MajicDesigns/FX888-Controller/media/photo/SS_Assembly1.JPG

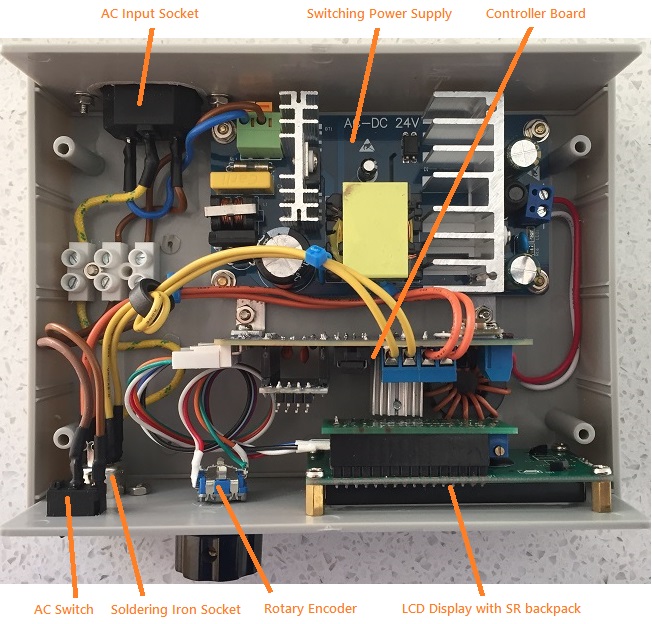
media/photo/SS_Assembly1.JPG
