MajicDesigns/FX888-Controller/media/photo/SS_BOM.jpg

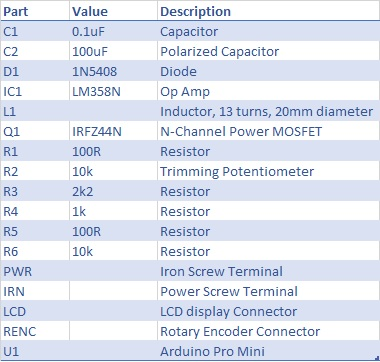
media/photo/SS_BOM.jpg
