MajicDesigns/FX888-Controller/README.md

Code to implement a Soldering station - Hakko Fx-888 soldering iron, LCD display and Rotary encoder user input.

Controller uses the PID algoritm and error shutdown is implemented.

This code accompanies the blog article at the [Arduino++ blog](https://arduinoplusplus.wordpress.com/2016/08/15/diy-soldering-station-with-hakko-fx-888-iron/)
