MajicDesigns/FX888-Controller/media/photo/SS_Block_Diagram.jpg

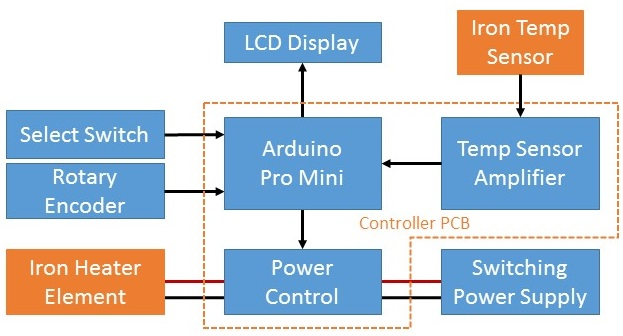
media/photo/SS_Block_Diagram.jpg
