MajicDesigns/FX888-Controller/media/photo/SS_Board1.JPG

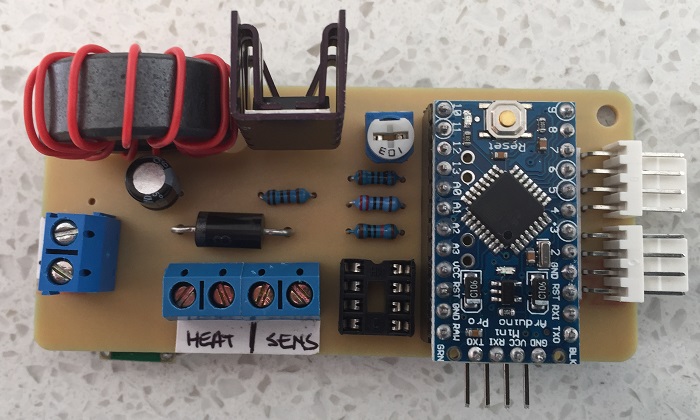
media/photo/SS_Board1.JPG
