MajicDesigns/FX888-Controller/media/photo/SS_Board2.JPG

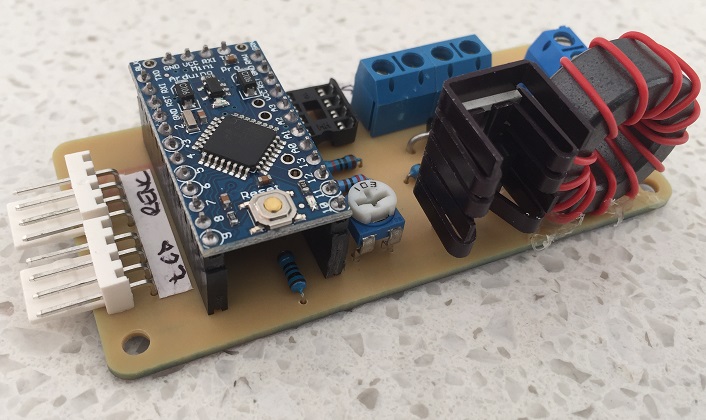
media/photo/SS_Board2.JPG
