MajicDesigns/FX888-Controller/media/photo/SS_Buck_Converter.JPG

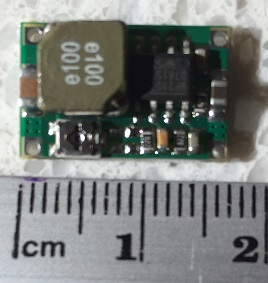
media/photo/SS_Buck_Converter.JPG
