MajicDesigns/FX888-Controller/media/photo/SS_Display_Design.jpg

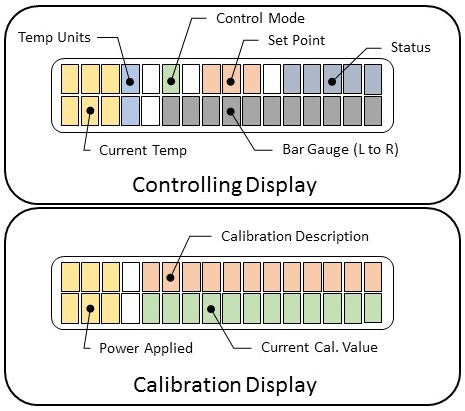
media/photo/SS_Display_Design.jpg
