MajicDesigns/FX888-Controller/media/photo/SS_Final.JPG

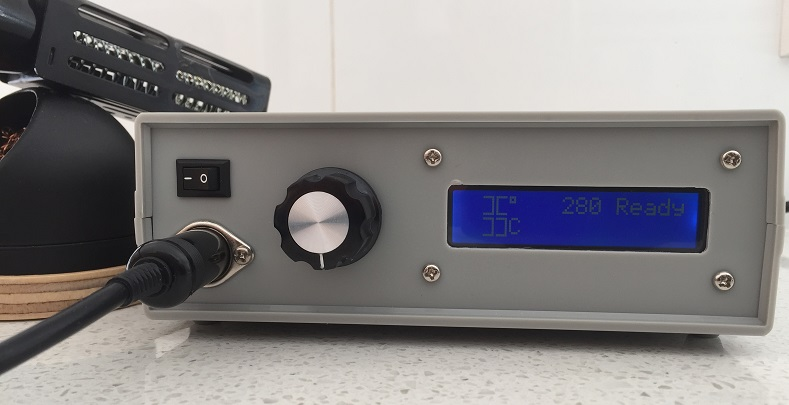
media/photo/SS_Final.JPG
