MajicDesigns/FX888-Controller/media/photo/SS_Front_Panel.JPG

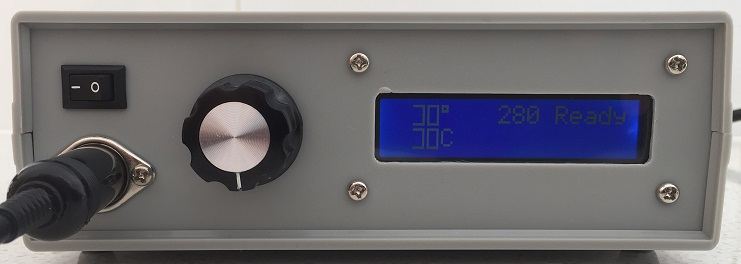
media/photo/SS_Front_Panel.JPG
