MajicDesigns/FX888-Controller/media/photo/SS_Hakko_FX888D_Pinouts.jpg

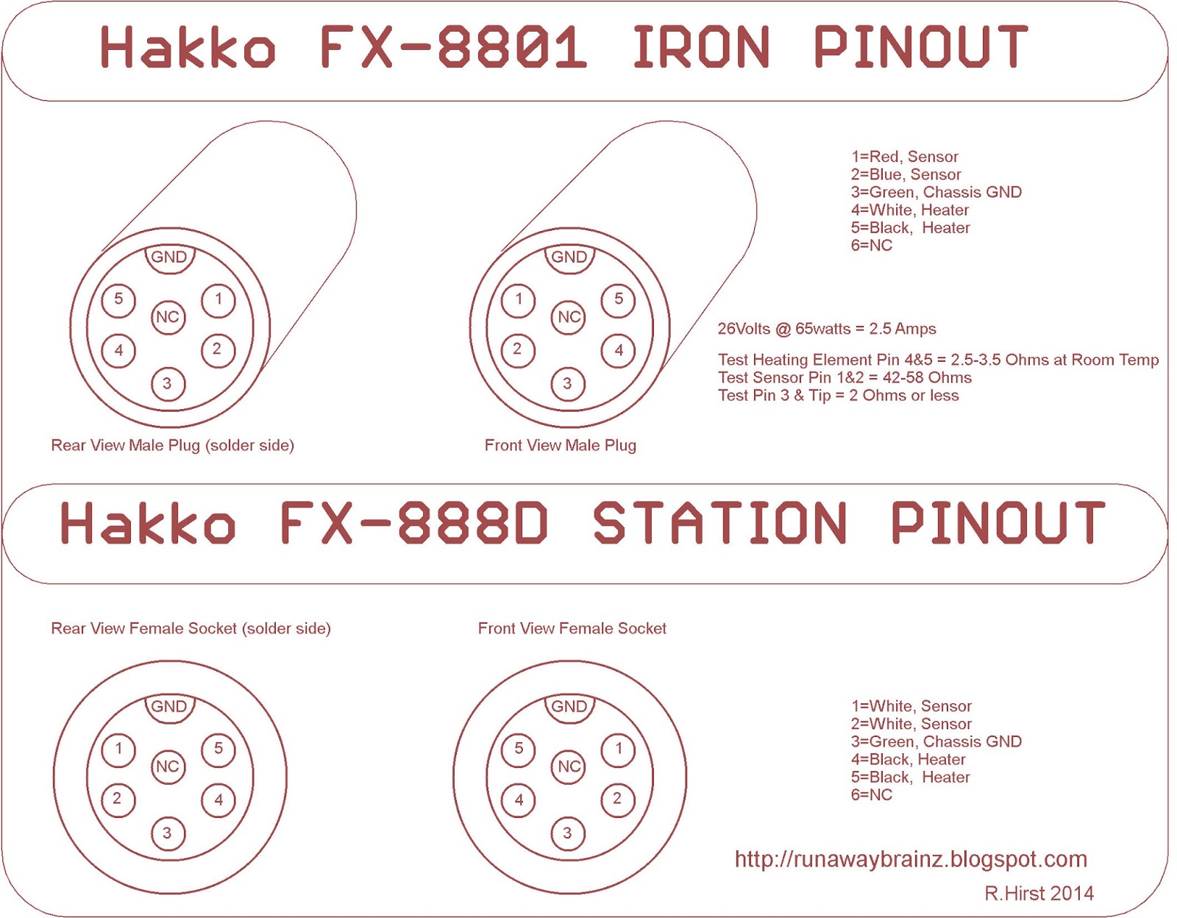
media/photo/SS_Hakko_FX888D_Pinouts.jpg
