MajicDesigns/FX888-Controller/media/photo/SS_Menu_Structure.jpg

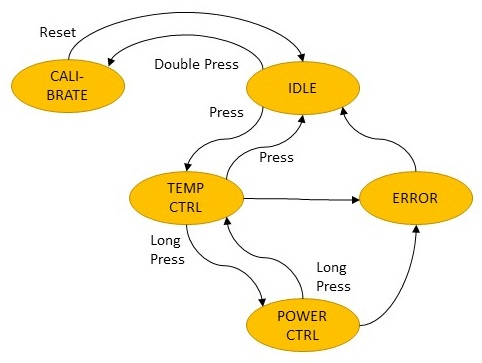
media/photo/SS_Menu_Structure.jpg
