MajicDesigns/FX888-Controller/media/photo/SS_PCB.JPG

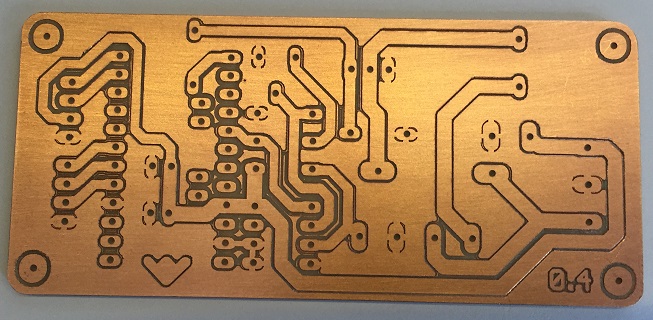
media/photo/SS_PCB.JPG
