MajicDesigns/FX888-Controller/media/photo/SS_PCB_Design.JPG

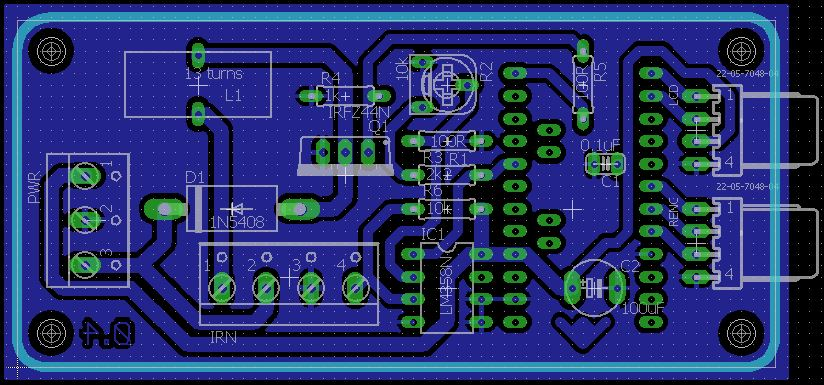
media/photo/SS_PCB_Design.JPG
