MajicDesigns/FX888-Controller/media/photo/SS_Schematic.JPG

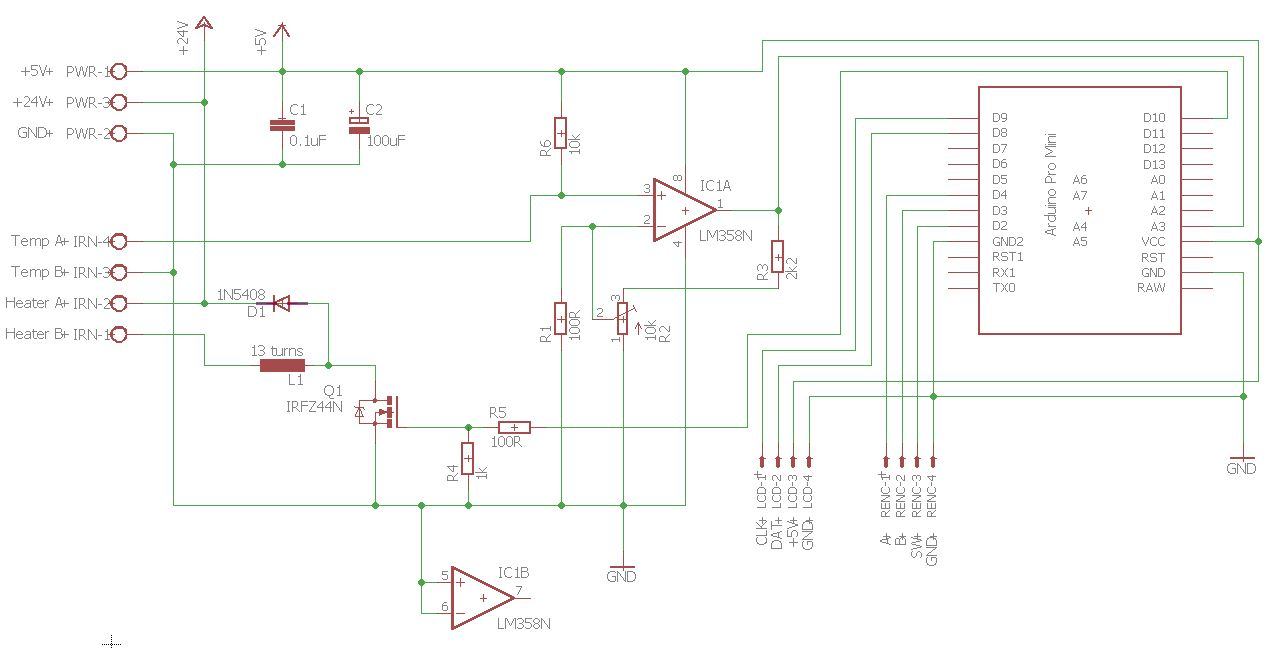
media/photo/SS_Schematic.JPG
