MajicDesigns/FX888-Controller/media/doc/Soldering Iron Controls v0.4 BOM.xlsx

Part | Value | Description
C1 | 0.1uF | Capacitor
C2 | 100uF | Polarized Capacitor
D1 | 1N5408 | Diode
IC1 | LM358N | Op Amp
L1 |  | Inductor, 13 turns, 20mm diameter
Q1 | IRFZ44N | N-Channel Power MOSFET
R1 | 100R | Resistor
R2 | 10k | Trimming Potentiometer
R3 | 2k2 | Resistor
R4 | 1k | Resistor
R5 | 100R | Resistor
R6 | 10k | Resistor
PWR |  | Iron Screw Terminal
IRN |  | Power Screw Terminal
LCD |  | LCD display Connector
RENC |  | Rotary Encoder Connector
U1 |  | Arduino Pro Mini
