MajicDesigns/FX888-Controller/media/doc/Soldering Station.pptx

Control Mode

Reset

CALI-BRATE

Double Press

Temp Units

Set Point

Status

Press

IDLE

Press

TEMP
CTRL

ERROR

Current Temp

Controlling Display

Calibration Description

Bar Gauge (L to R)

Long Press

POWER
CTRL

Long Press

Power Applied

Calibration Display

Current Cal. Value

## Slide 2

LCD Display

Arduino
Pro Mini

Power Control

Iron Temp
Sensor

Temp Sensor Amplifier

Switching Power Supply

Select Switch

Rotary Encoder

Controller PCB

Iron Heater
Element
