MajicDesigns/FX888-Controller/media/doc/Soldering Controller Tuning.xlsx

Sheet: run1
 | SP | CO | CV
0 | 586 | 241 | 356
0.5 | 586 | 55 | 483
1 | 586 | 69 | 527
1.5 | 586 | 164 | 370
2 | 586 | 58 | 529
2.5 | 586 | 126 | 377
3 | 586 | 197 | 364
3.5 | 586 | 209 | 548
4 | 586 | 231 | 544
4.5 | 586 | 32 | 394
5 | 586 | 21 | 396
5.5 | 586 | 239 | 403
6 | 586 | 118 | 518
6.5 | 586 | 171 | 555
7 | 586 | 187 | 552
7.5 | 586 | 113 | 519
8 | 586 | 76 | 386
8.5 | 586 | 129 | 423
9 | 586 | 159 | 371
9.5 | 586 | 101 | 428
10 | 586 | 90 | 430
10.5 | 586 | 39 | 579
11 | 586 | 187 | 433
11.5 | 586 | 22 | 577
12 | 586 | 235 | 438
12.5 | 586 | 98 | 578
13 | 586 | 8 | 405
13.5 | 586 | 250 | 442
14 | 586 | 218 | 586
14.5 | 586 | 26 | 593
15 | 586 | 129 | 454
15.5 | 586 | 78 | 456
16 | 586 | 151 | 455
16.5 | 586 | 84 | 599
17 | 586 | 30 | 460
17.5 | 586 | 8 | 457
18 | 586 | 77 | 456
18.5 | 586 | 173 | 451
19 | 586 | 225 | 412
19.5 | 586 | 101 | 605
20 | 586 | 94 | 464
20.5 | 586 | 49 | 464
21 | 586 | 104 | 465
21.5 | 586 | 40 | 608
22 | 586 | 0 | 466
22.5 | 586 | 210 | 466
23 | 586 | 76 | 579
23.5 | 586 | 146 | 459
24 | 586 | 57 | 469
24.5 | 586 | 117 | 470
25 | 586 | 20 | 454
25.5 | 586 | 236 | 469
26 | 586 | 143 | 577
26.5 | 586 | 61 | 481
27 | 586 | 29 | 483
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
