MajicDesigns/FX888-Controller/media/photo/SS_Assembly2.JPG

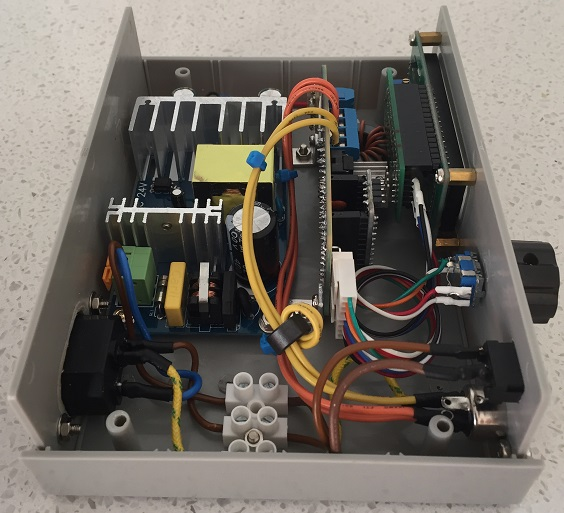
media/photo/SS_Assembly2.JPG
