MajicDesigns/FX888-Controller/media/photo/SS_Assembly_front.JPG

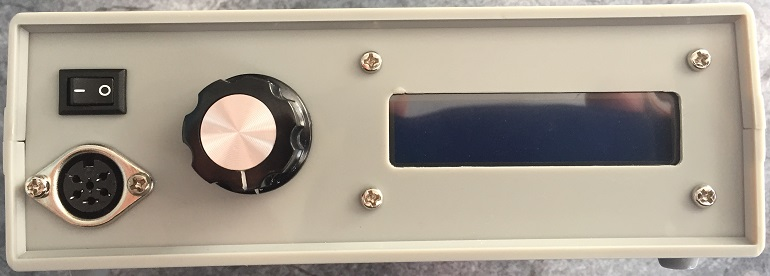
media/photo/SS_Assembly_front.JPG
