MajicDesigns/FX888-Controller/media/photo/SS_PCB_Making.JPG

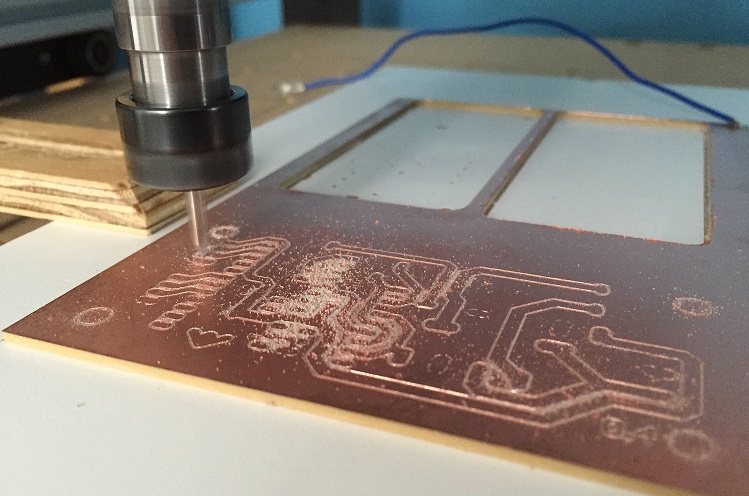
media/photo/SS_PCB_Making.JPG
