MajicDesigns/FX888-Controller/media/photo/SS_Tuning_1.jpg

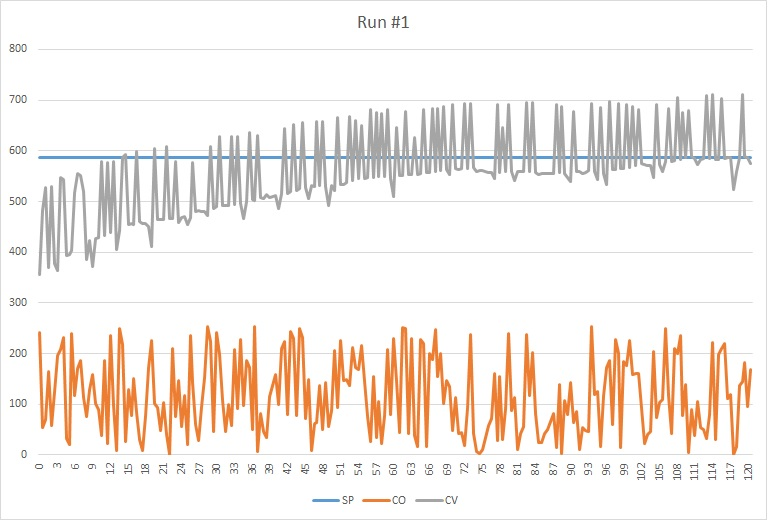
media/photo/SS_Tuning_1.jpg
