MajicDesigns/FX888-Controller/media/photo/SS_Tuning_6.png

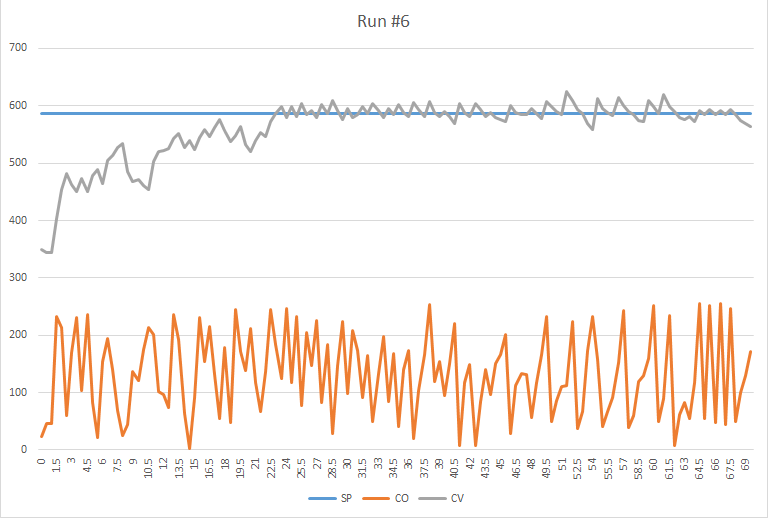
media/photo/SS_Tuning_6.png
