MajicDesigns/FX888-Controller/media/photo/SS_Tuning_Separated.png

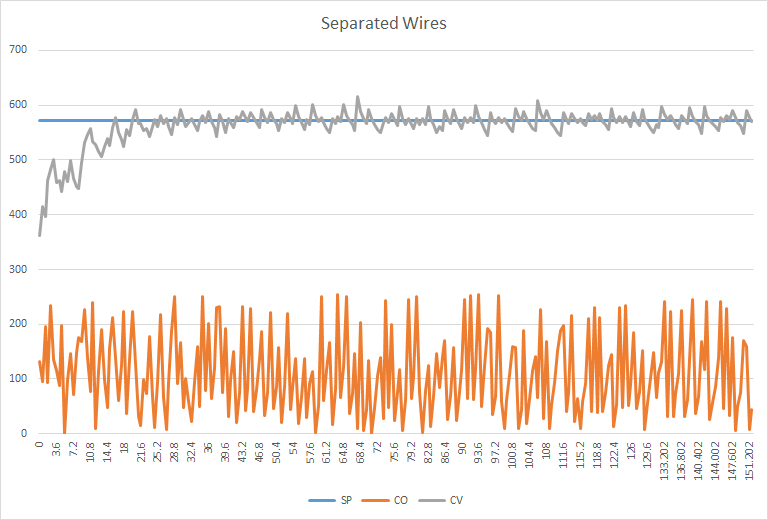
media/photo/SS_Tuning_Separated.png
