MajicDesigns/FX888-Controller/media/photo/SS_Tuning_SPChange.png

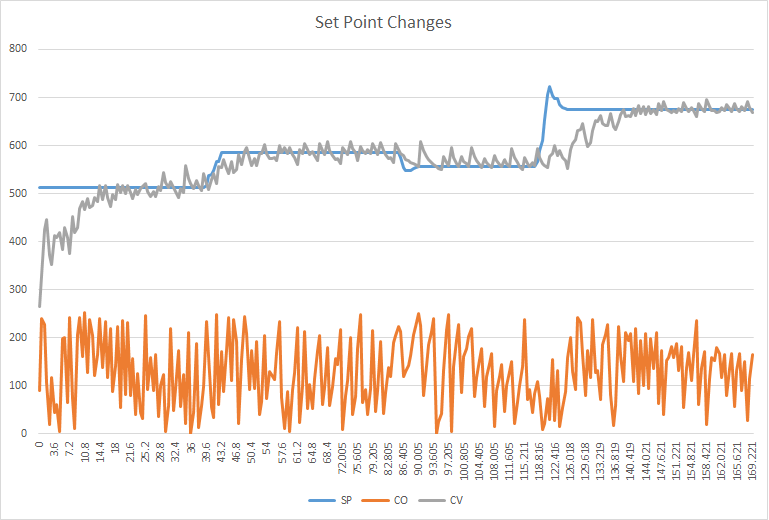
media/photo/SS_Tuning_SPChange.png
